TheDarkKiwi/cnc_design/CNC Project/Concept Idea Lucas.SLDASM

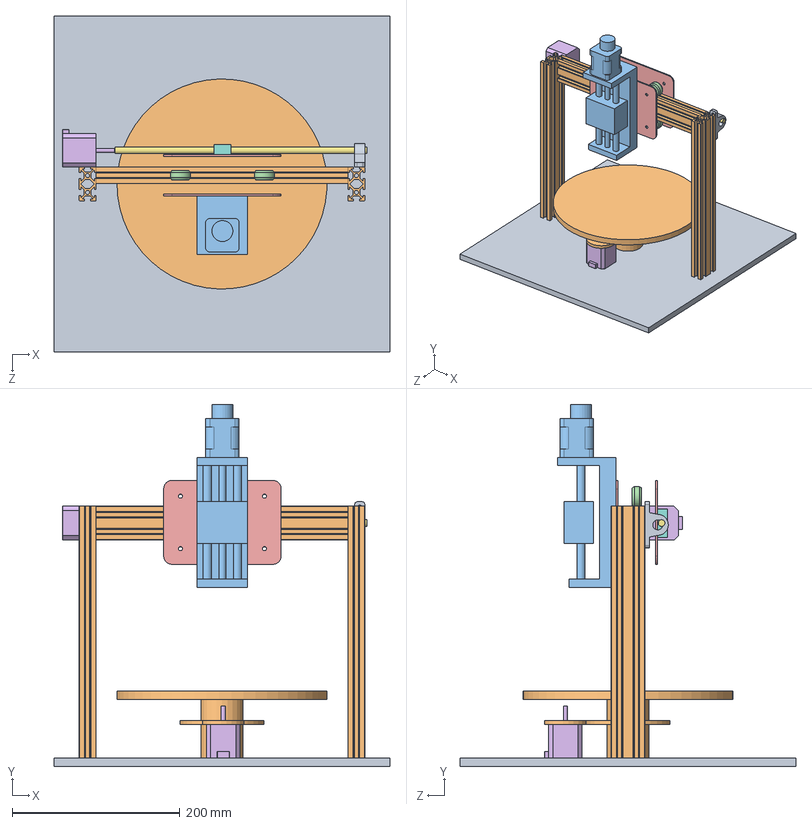
[picture p15: CAD file, 2024-12-19]
CNC Project/Concept Idea Lucas.SLDASM
400.0 x 431.3 x 400.0 mm
platform
Aluminum beam x 3
Verticle mover
Black ring bearing x 4
vertical bracket x 2
motor x 2
SCREW ROD
Lego Brick
Mountable Bearing
turntable
