TheDarkKiwi/cnc_design/CNC Project/custom parts/platform.SLDPRT

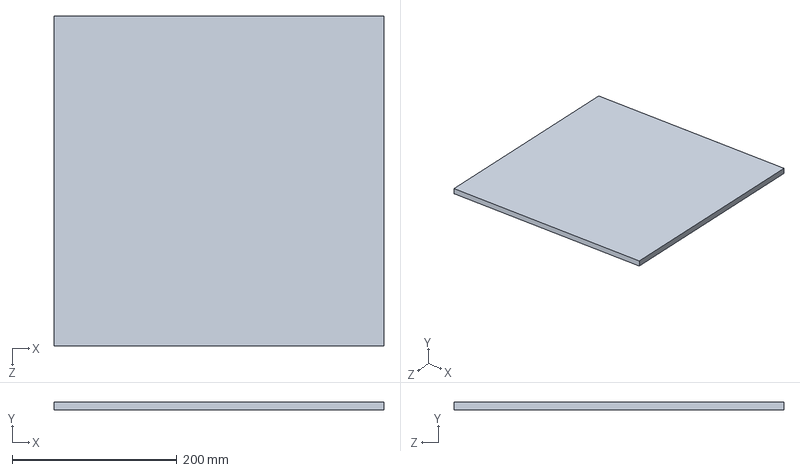
[picture p16: CAD file, 2024-12-19]
CNC Project/custom parts/platform.SLDPRT
400.0 x 10.0 x 400.0 mm
