TheDarkKiwi/cnc_design/CNC Project/parts/motor.SLDPRT

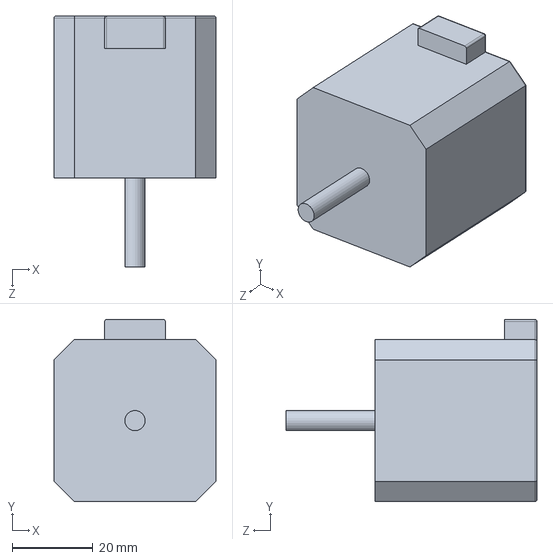
[picture p17: CAD file, 2024-12-19]
CNC Project/parts/motor.SLDPRT
40.0 x 45.0 x 62.0 mm
