TheDarkKiwi/cnc_design/CNC Project/custom parts/vertical bracket.SLDPRT

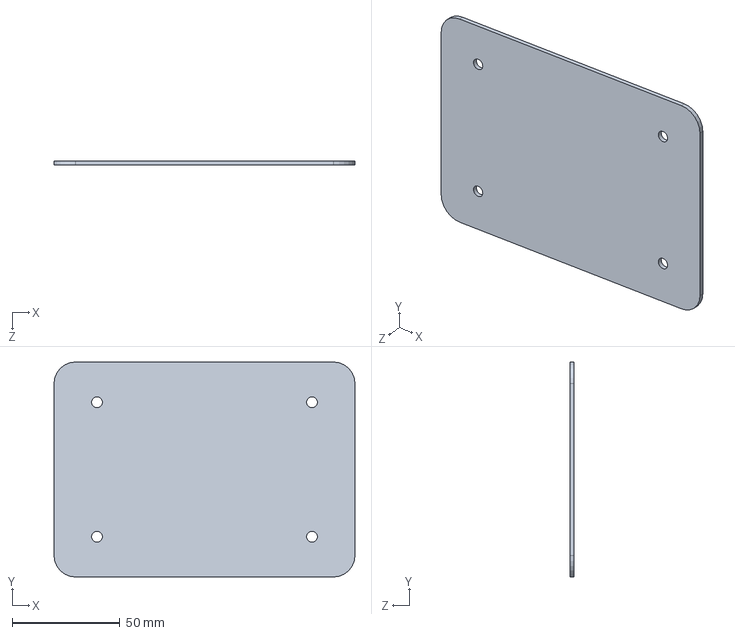
[picture p18: CAD file, 2024-12-19]
CNC Project/custom parts/vertical bracket.SLDPRT
140.0 x 100.0 x 2.00 mm
