TheDarkKiwi/cnc_design/CNC Project/parts/Mountable Bearing.SLDPRT

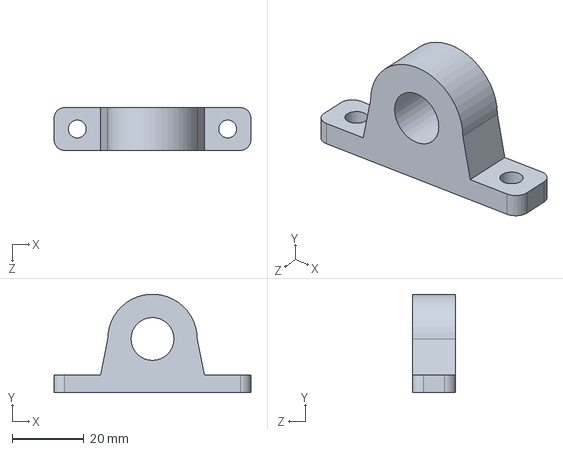
[picture p19: CAD file, 2024-12-19]
CNC Project/parts/Mountable Bearing.SLDPRT
55.0 x 27.5 x 12.0 mm
