TheDarkKiwi/cnc_design/CNC Project/parts/Verticle mover.SLDPRT

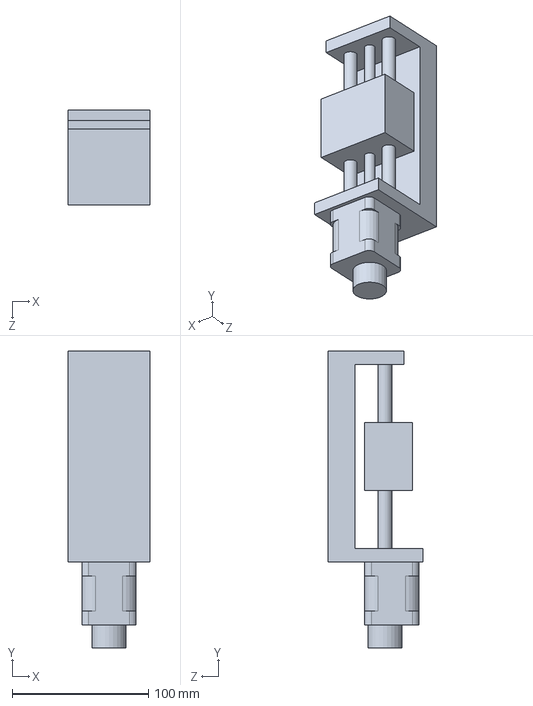
[picture p20: CAD file, 2024-12-19]
CNC Project/parts/Verticle mover.SLDPRT
60.0 x 218.0 x 70.0 mm
