TheDarkKiwi/cnc_design/CNC Project/custom parts/turntable.SLDPRT

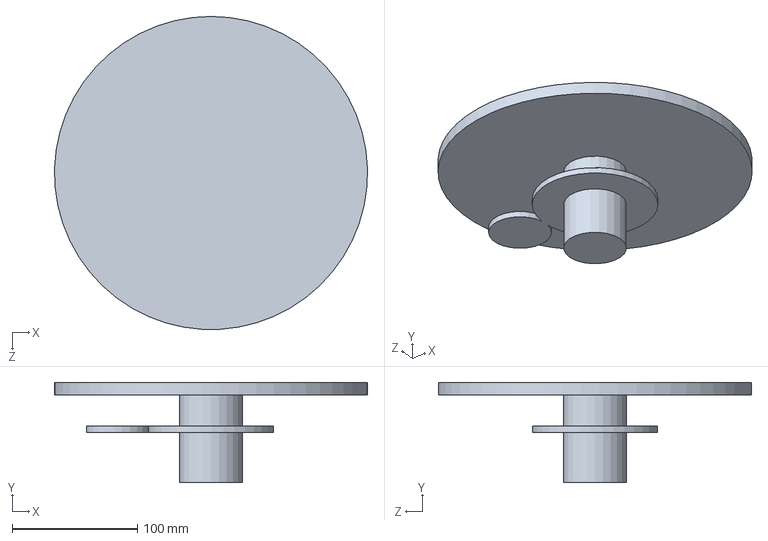
[picture p21: CAD file, 2024-12-19]
CNC Project/custom parts/turntable.SLDPRT
249.9 x 80.0 x 250.0 mm
