TheDarkKiwi/cnc_design/CNC Project/parts/Cylinder bearing.SLDPRT

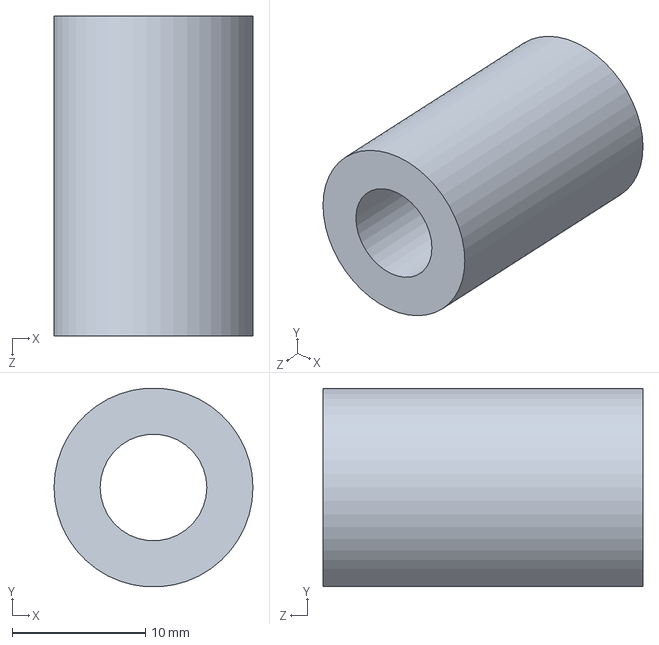
[picture p22: CAD file, 2024-12-19]
CNC Project/parts/Cylinder bearing.SLDPRT
14.9 x 14.9 x 24.0 mm
