TheDarkKiwi/cnc_design/CNC Project/parts/Slider rod.SLDPRT

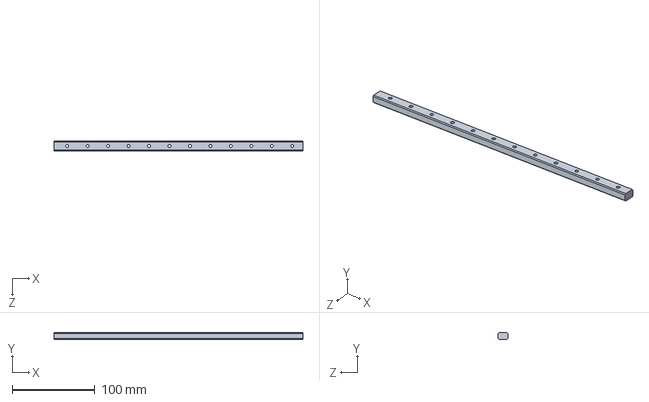
[picture p23: CAD file, 2024-12-19]
CNC Project/parts/Slider rod.SLDPRT
300.0 x 8.00 x 12.0 mm
