TheDarkKiwi/cnc_design/CNC Project/parts/Slider1.SLDPRT

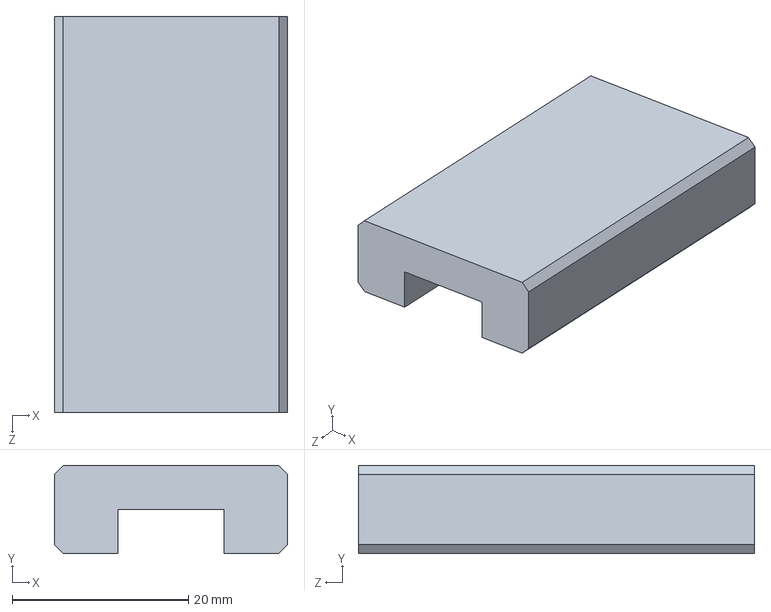
[picture p24: CAD file, 2024-12-19]
CNC Project/parts/Slider1.SLDPRT
26.5 x 10.0 x 45.0 mm
