TheDarkKiwi/cnc_design/CNC Project/parts/Lego Brick.SLDPRT

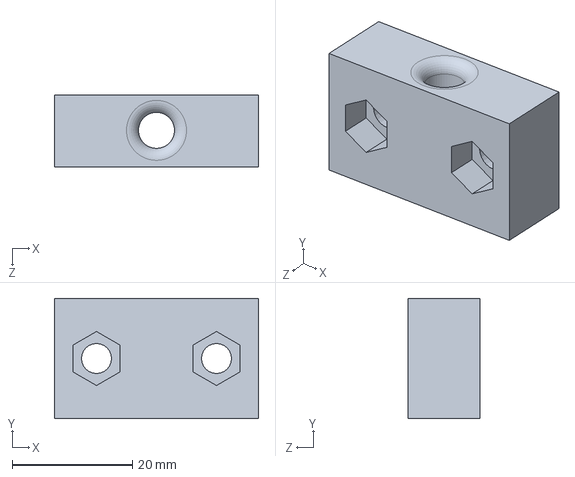
[picture p25: CAD file, 2024-12-19]
CNC Project/parts/Lego Brick.SLDPRT
34.0 x 20.0 x 12.0 mm
