TheDarkKiwi/cnc_design/CNC Project/parts/Black ring bearing.SLDPRT

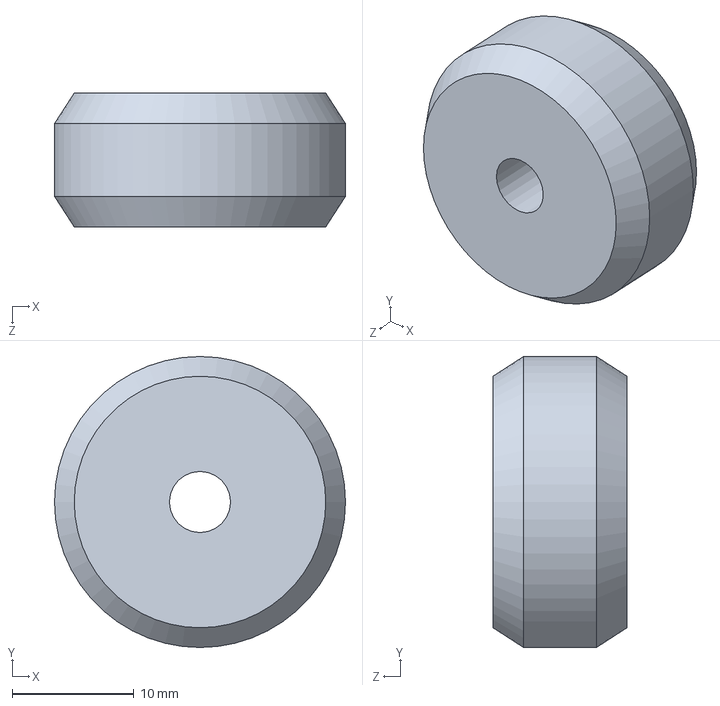
[picture p26: CAD file, 2024-12-19]
CNC Project/parts/Black ring bearing.SLDPRT
23.9 x 23.9 x 11.0 mm
