TheDarkKiwi/cnc_design/CNC Project/parts/SOLDER FEEDER.SLDPRT

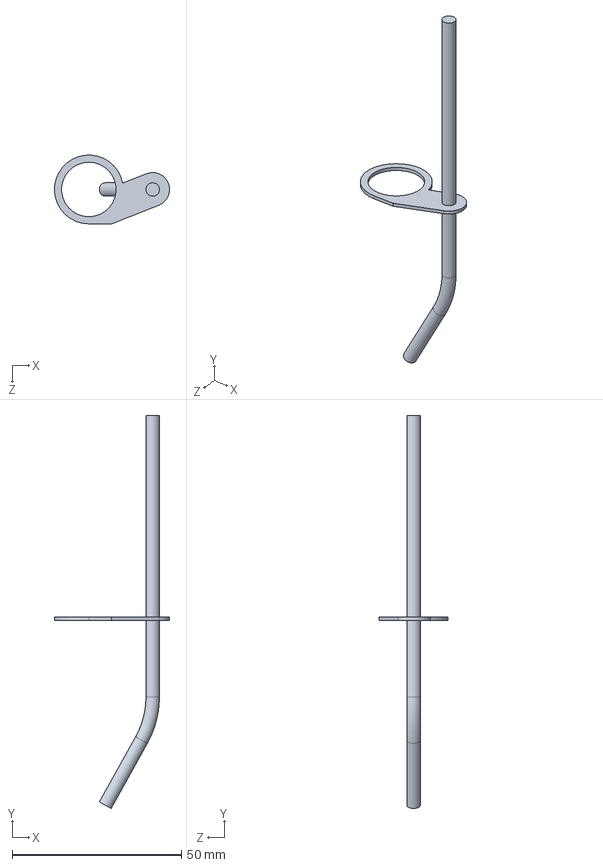
[picture p27: CAD file, 2024-12-19]
CNC Project/parts/SOLDER FEEDER.SLDPRT
33.9 x 116.0 x 20.3 mm
