TheDarkKiwi/cnc_design/CNC Project/parts/0.8 bearing.SLDPRT

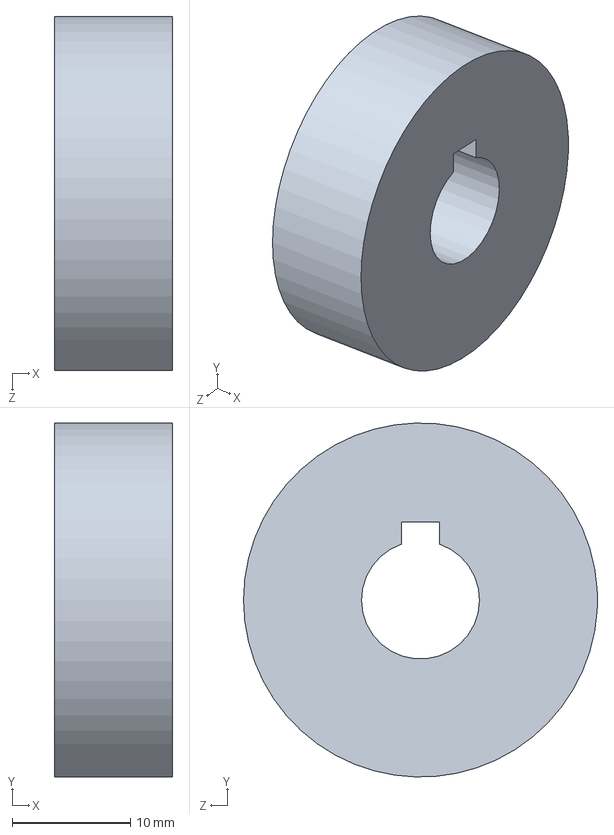
[picture p28: CAD file, 2024-12-19]
CNC Project/parts/0.8 bearing.SLDPRT
10.0 x 30.0 x 30.0 mm
