TheDarkKiwi/cnc_design/CNC Project/parts/Silver bearing.SLDPRT

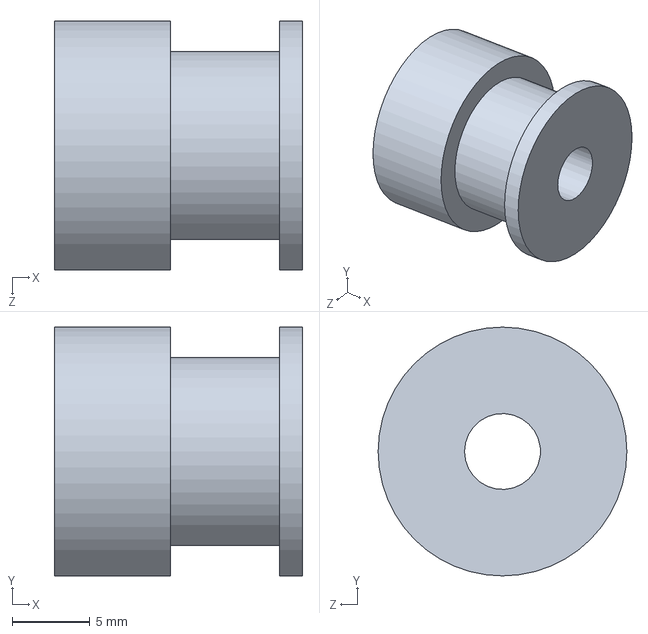
[picture p29: CAD file, 2024-12-19]
CNC Project/parts/Silver bearing.SLDPRT
16.0 x 16.0 x 16.0 mm
