TheDarkKiwi/cnc_design/CNC Project/parts/Aluminum beam.SLDPRT

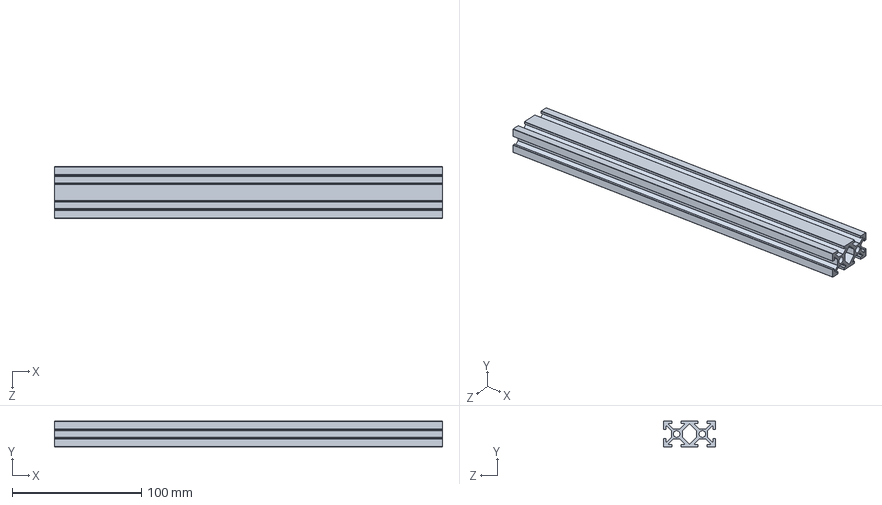
[picture p30: CAD file, 2024-12-19]
CNC Project/parts/Aluminum beam.SLDPRT
300.0 x 20.0 x 40.0 mm
