TheDarkKiwi/cnc_design/CNC Project/parts/BEARING WITH LIP.SLDPRT

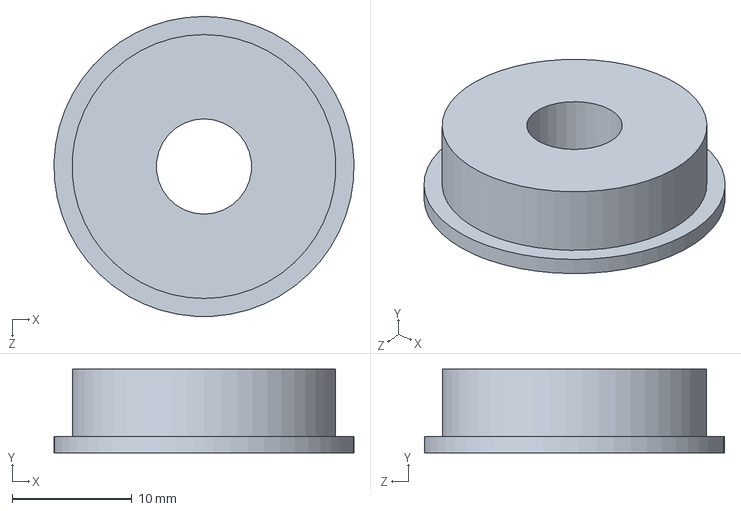
[picture p31: CAD file, 2024-12-19]
CNC Project/parts/BEARING WITH LIP.SLDPRT
25.0 x 6.98 x 25.0 mm
