TheDarkKiwi/cnc_design/CNC Project/parts/corner bracket.SLDPRT

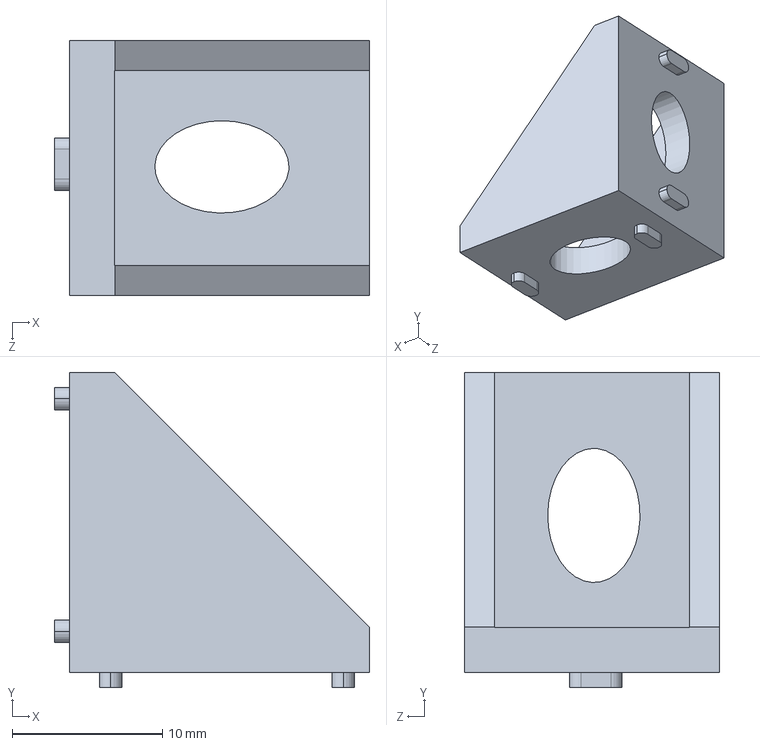
[picture p32: CAD file, 2024-12-19]
CNC Project/parts/corner bracket.SLDPRT
21.0 x 21.0 x 17.0 mm
