TheDarkKiwi/cnc_design/(list of files, cad)

Other CAD files:
CNC Project/parts/Slider.SLDPRT
CNC Project/Concept Idea Lucas.SLDDRW
CNC Project/custom parts/Golden nut.SLDPRT
CNC Project/parts/BEARING WITH SCREW HOLES.SLDPRT
CNC Project/parts/MOTOR TO SCREW.SLDPRT
CNC Project/parts/SCREW ROD.SLDPRT
